Frrrrrrrrrank/CAN_Debugger/CAN_Debugger.kicad/CAN_Debugger.kicad_pcb

## KiCad design CAN_Debugger.kicad/CAN_Debugger.kicad_pcb (2023-10-15)

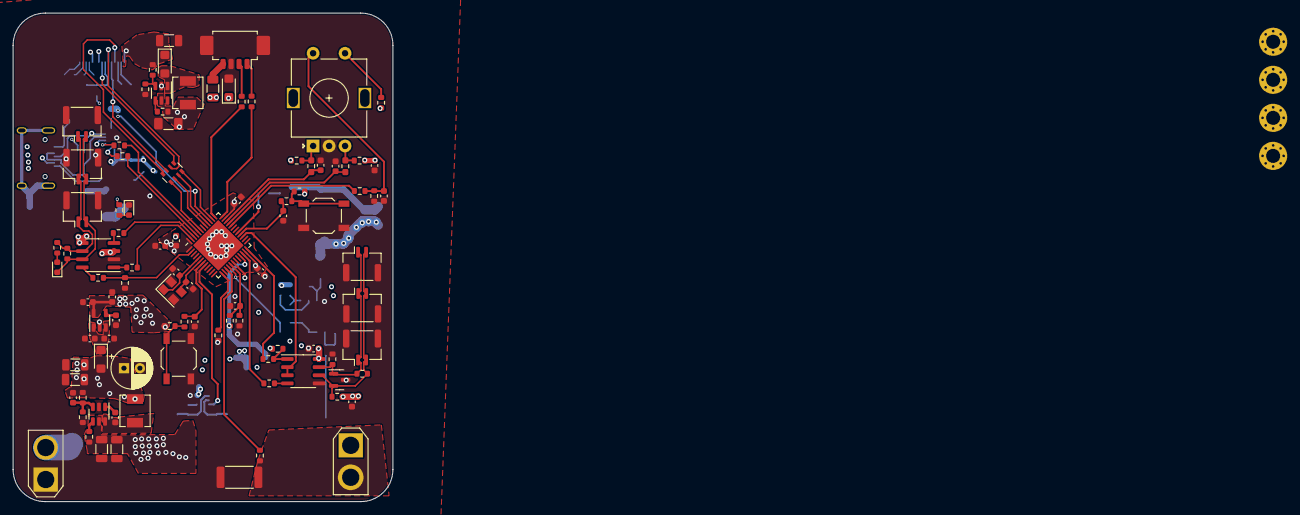
[picture p1: board CAN_Debugger.kicad_pcb from above]

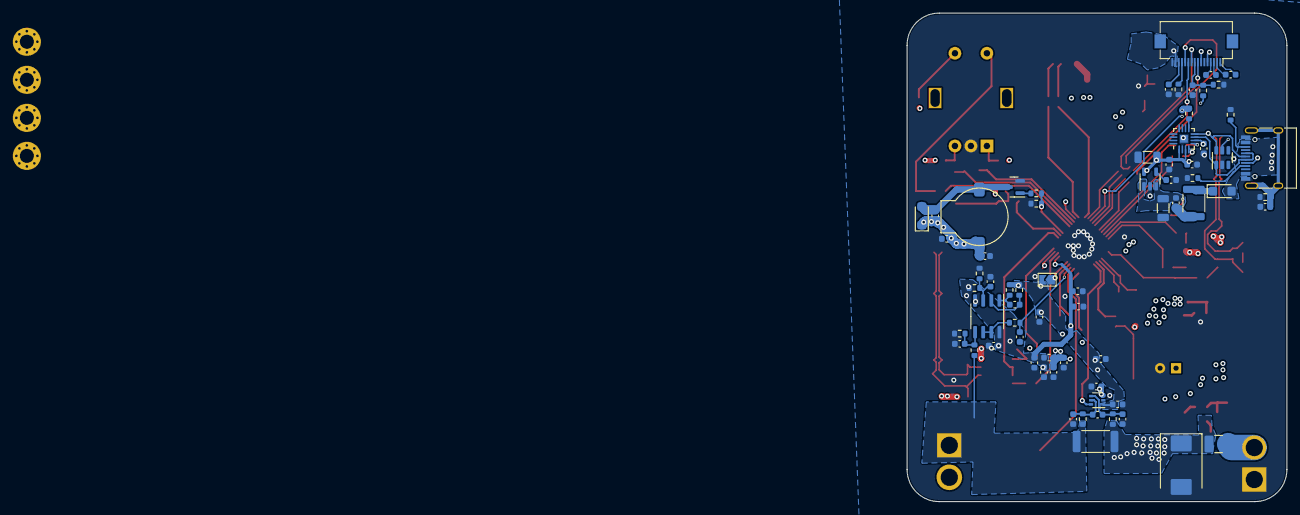
[picture p2: board CAN_Debugger.kicad_pcb from below]

Board: 4 copper layers, 59.4 x 76.4 mm, 169 parts (68 on the bottom side), 102 nets.

Parts:
BZ1: Buzzer; MLT-9032
C1, C2, C6, C7, C37, C45: 10uF; C_1206_3216Metric
C3: 47uF; CP_Radial_D6.3mm_P2.50mm
C4, C9, C12, C25, C26, C27, C28, C30, C31, C33, C34, C35, C38, C39, C40, C41, C42, C46, C49, C50, C57, C58, C59, C70, C76, C88, C104, C105: 100n; C_0603_1608Metric
C5, C8, C14, C23: 20p; C_0603_1608Metric
C10, C13, C22, C24, C29, C80: 10u; C_0603_1608Metric
C11: 10n; C_0603_1608Metric
C15, C16: 1uf; C_0603_1608Metric
C17: 2.2uf; C_0603_1608Metric
C20, C21, C36: 100nF; C_0603_1608Metric
C32, C47, C52, C53, C54: C; C_0603_1608Metric
C43, C44: 10nF; C_0603_1608Metric
C48: 22u; C_1206_3216Metric
C51: 22u; C_1206_3216Metric_Pad1.33x1.80mm_HandSolder
D1: SMCJ28A; D_SMC
D3, D5, D6, D10: D_Schottky; D_SMF
D4, D9: LED; LED_0603_1608Metric
D7: SMF3.3A; D_SMF
D8: SM712; SOT-23
F1: Fuse; Fuse_1210_3225Metric_Pad1.42x2.65mm_HandSolder
F2: Polyfuse; Fuse_1206_3216Metric
F4: Fuse; Fuse_1812_4532Metric
FB1: 120R@100MHz; L_0603_1608Metric
H1, H2, H3, H4: MountingHole_Pad; MountingHole_2.2mm_M2_Pad_Via
J1: Conn_01x02; AMASS_XT30U-M_1x02_P5.0mm_Vertical
J2: Conn_01x04_MountingPin; Molex_PicoBlade_53261-0471_1x04-1MP_P1.25mm_Horizontal
J3: Conn_01x02; AMASS_XT30U-F_1x02_P5.0mm_Vertical
J4: Conn_01x16_Socket; Hirose_FH12-16S-0.5SH_1x16-1MP_P0.50mm_Horizontal
J5: USB_C_Receptacle_USB2.0; USB_C_Receptacle_HRO_TYPE-C-31-M-12
J6: RS-485; JST_GH_BM02B-GHS-TBT_1x02-1MP_P1.25mm_Vertical
J7, J8, J9: CAN; JST_GH_BM02B-GHS-TBT_1x02-1MP_P1.25mm_Vertical
J15, J16: RS-485; JST_GH_SM02B-GHS-TB_1x02-1MP_P1.25mm_Horizontal
JP1: SolderJumper_2_Open; SolderJumper-2_P1.3mm_Open_TrianglePad1.0x1.5mm
L1: L; L_Sunlord_MWSA0402S
L2: 4.7u; L_Sunlord_MWSA0402S
L3: L_Ferrite; L_0603_1608Metric
Q1: AO3400A; SOT-23
R1, R3, R10, R19, R23, R28, R38, R39, R40, R42, R50: 10k; R_0603_1608Metric
R2: 53.6k; R_0603_1608Metric
R4, R44: R; R_2512_6332Metric
R5: 330R; R_0603_1608Metric
R6, R31: 10k; R_0603_1608Metric_Pad0.98x0.95mm_HandSolder
R7, R8, R11, R20, R63: 33r; R_0603_1608Metric
R9, R12, R13, R57: 120r; R_0603_1608Metric
R14, R15, R45, R51: R; R_0603_1608Metric
R16, R17, R21: 100k 25ppm; R_0603_1608Metric
R18, R22, R27: 330; R_0603_1608Metric
R24, R62: 1k; R_0603_1608Metric
R25: 10k 25ppm; R_0603_1608Metric
R29: 120R; R_0603_1608Metric
R30, R36: 10K; R_0603_1608Metric
R32, R33: 33R; R_0603_1608Metric
R34, R35: 5.1k; R_0603_1608Metric
R37: 1M; R_0603_1608Metric
R41, R48, R52: 100k; R_0603_1608Metric
R53, R56, R58: 4.7k; R_0603_1608Metric
R54, R55: 100; R_0603_1608Metric
R59, R60: 100r 25ppm; R_0603_1608Metric
R61: 19k; R_0603_1608Metric
RN1: R_Pack04; R_Array_Convex_4x0603
SW1, SW3: SW_Push; SW_SPST_TL3342
SW4: RotaryEncoder_Switch; RotaryEncoder_Alps_EC11E-Switch_Vertical_H20mm
U1: SN75176AD; SOIC-8_3.9x4.9mm_P1.27mm
U2: RY8411; SOT-23-6
U3, U10: RS3236; SOT-23-5
U5: SIT1042T/3; SOIC-8_3.9x4.9mm_P1.27mm
U6: IP4220CZ6; SOT-23-6
U7: INA186; SOT-363_SC-70-6
U8: STM32G431CBUx; QFN-48-1EP_7x7mm_P0.5mm_EP5.6x5.6mm
U9: CH343P; TQFN-16-1EP_3x3mm_P0.5mm_EP1.23x1.23mm
U13: MT3608; SOT-23-6
U14: GS8332-SR; SOIC-8_3.9x4.9mm_P1.27mm
Y1: 25MHz; Crystal_SMD_3225-4Pin_3.2x2.5mm

Connections:
24v_motor: J3.1, R4.2, R21.2, R60.1
+3.3V: C12.1, C13.1, C25.1, C26.1, C27.1, C28.1, C32.1, C41.1, C42.1, C52.1, D7.1 (A1), F2.1, J4.7, L3.1, R19.1, R23.1, R38.1, R39.2, R40.1, R53.1, U3.5 (OUT), U5.5 (VIO), U7.3 (V+), U8.1 (VBAT), U8.23 (VDD), U8.35 (VDD), U8.48 (VDD)
+3.3VA: C29.1, C30.1, C53.1, C54.1, C70.1, L3.2, R16.2, R48.1, U8.21 (VDDA), U14.8 (VDD)
+3.3V_USBTTL: C20.1, C21.1, C36.1, C45.1, U9.1 (VIO), U9.3 (VDD5), U9.6 (V3), U10.5 (OUT)
+5V: BZ1.2 (+), C1.1, C2.1, C3.1, C5.1, C22.2, C23.2, C24.2, C49.1, C50.1, C51.1, D3.2 (A), D5.1 (K), J4.5, L1.2, L2.1, R2.1, R50.1, R58.2, U1.8 (VCC), U5.3 (VCC), U13.5 (IN)
+24V: C6.1, C7.1, D1.1 (K), F1.1, R1.1, R4.1, R59.1, U2.5 (IN)
/1.65Vref: C40.1, C76.1, C80.1, JP1.2 (B), R20.1, R24.1, U7.1 (REF)
/VBUS_CONNECTOR: D6.2 (A), J5.A4 (VBUS), J5.A9 (VBUS), J5.B4 (VBUS), J5.B9 (VBUS)
A+: D8.2 (A2), J6.2, J15.2, J16.2, R57.2, R58.1, U1.6 (A)
A_I: U7.6, U8.8 (PA0)
B-: D8.1 (A1), J6.1, J15.1, J16.1, R56.2, R57.1, U1.7 (B)
BUZZER: R10.2, R11.1, U8.29 (PC6)
C1N: C16.2, J4.4
C1P: C16.1, J4.3
C2N: C15.2, J4.2
C2P: C15.1, J4.1
CANH: D9.1 (K), J7.2, J8.2, J9.2, R9.2, U5.7 (CANH)
CANL: J7.1, J8.1, J9.1, R9.1, R15.1, U5.6 (CANL)
CAN_RX: R8.1, U8.46 (PB8)
CAN_STB: R29.1, R30.1, U8.2 (PC13)
CAN_TX: R7.1, U8.47 (PB9)
CS: J4.8, RN1.5 (R4.2)
D/C: J4.10, RN1.6 (R3.2)
Encoder_button: R42.1, U8.32 (PA10)
GND: C1.2, C2.2, C3.2, C6.2, C7.2, C8.2, C9.2, C10.2, C11.2, C12.2, C13.2, C14.2, C17.2, C20.2, C21.2, C22.1, C24.1, C25.2, C26.2, C27.2, C28.2, C29.2, C30.2, C31.1, C32.2, C33.1, C35.1, C36.2, C37.2, C38.1, C39.2, C40.2, C41.2, C42.2, C43.1, C44.2, C45.2, C46.2, C47.2, C48.2, C49.2, C50.2, C51.2, C52.2, C53.2, C54.2, C57.2, C59.2, C70.2, C76.2, C80.2, C88.1, C104.1, C105.2, D1.2 (A), D4.1 (K), D7.2 (A2), D8.3 (common), J1.1, J2.3, J2.MP (MountPin), J4.16, J5.A1 (GND), J5.A12 (GND), J5.B1 (GND), J5.B12 (GND), J6.MP (MountPin), J7.MP (MountPin), J8.MP (MountPin), J9.MP (MountPin), J15.MP (MountPin), J16.MP (MountPin), Q1.2 (S), R3.2, R10.1, R14.2, R17.1, R25.1, R28.2, R30.2, R34.1, R35.1, R37.1, R41.2, R44.1, R51.2, R52.2, R56.1, R62.2, SW1.2, SW3.2, SW4.C, U1.5 (GND), U2.2 (GND), U3.2 (GND), U5.2 (GND), U6.2 (VN), U7.2 (GND), U8.49 (VSS), U9.2 (GND), U9.17 (GND), U10.2 (GND), U13.2 (GND), U14.4 (VSS), Y1.2, Y1.4
IREF: J4.13, R14.1
NRST: C31.2, R18.2, U8.7 (PG10)
unnamed: BZ1.1 (-), C23.1, D5.2 (A), Q1.3 (D)
unnamed: C46.1, R41.1, R42.2, SW4.S2
unnamed: C57.1, R16.1, R17.2, U14.3 (+)
unnamed: C58.2, R24.2, U14.2 (-)
unnamed: C59.1, R21.1, R25.2, U14.5 (+)
unnamed: C9.1, C10.1, D3.1 (K), U3.1 (IN), U3.3 (EN)
unnamed: D4.2 (A), R36.2
unnamed: D6.1 (K), F4.2
unnamed: D9.2 (A), R15.2
unnamed: D10.2 (A), L2.2, U13.1 (SW)
unnamed: F4.1, FB1.2
unnamed: F1.2, J1.2
unnamed: J2.1, R13.2
unnamed: J2.2, R12.2
unnamed: F2.2, J2.4
unnamed: J5.A5 (CC1), R34.2
unnamed: J5.B5 (CC2), R35.2
unnamed: C43.2, J5.S1 (SHIELD), R37.2
unnamed: Q1.1 (G), R11.2
unnamed: R18.1, R19.2, SW1.1
unnamed: R22.1, R23.2, SW3.1
unnamed: R31.2, R38.2, SW4.B
unnamed: R6.2, R39.1, SW4.A
unnamed: R40.2, SW4.S1
unnamed: R54.1, U1.4 (D)
unnamed: R53.2, R55.2, U1.1 (R)
unnamed: C4.1, U2.1 (BS)
unnamed: R1.2, U2.4 (EN)
unnamed: C5.2, R2.2, R3.1, U2.3 (FB)
unnamed: C4.2, L1.1, U2.6 (LX)
unnamed: C11.1, U3.4 (BP/FB)
unnamed: R8.2, U5.4 (RXD)
unnamed: R29.2, U5.8 (STB)
unnamed: R7.2, U5.1 (TXD)
unnamed: C34.1, C104.2, R59.2, U7.4 (+)
unnamed: C34.2, C105.1, R60.2, U7.5 (-)
unnamed: R32.2, U9.5 (RXD)
unnamed: R33.1, U9.4 (TXD)
unnamed: R5.1, U9.9 (VBUS)
unnamed: C44.1, U10.4 (BP)
unnamed: R50.2, U13.4 (EN)
unnamed: R61.2, R62.1, U13.3 (FB)
unnamed: C58.1, R20.2, U14.1 (OUTA)
unnamed: R63.1, U14.6 (-), U14.7 (OUTB)
PA5: R51.1, U8.13 (PA5)
PA7: R45.1, U8.15 (PA7)
PA11: C39.1, R31.1, U8.33 (PA11)
PA12: C38.2, R6.1, U8.34 (PA12)
PA15: RN1.4 (R4.1), U8.38 (PA15)
PB0: C47.1, R48.2, R52.1, U8.17 (PB0)
PB1: JP1.1 (A), U8.18 (PB1)
PB6: R32.1, U8.44 (PB6)
PB7: R33.2, U8.45 (PB7)
PB10: R54.2, U8.22 (PB10)
PB11: R55.1, U8.24 (PB11)
PB14: U1.2 (~RE), U1.3 (DE), U8.27 (PB14)
PB15: C33.2, R22.2, U8.28 (PB15)
PC4: C88.2, R63.2, U8.16 (PC4)
PC10: R27.1, U8.39 (PC10)
PC11: RN1.3 (R3.1), U8.40 (PC11)
RCC_OSC_IN: C14.1, U8.5 (PF0), Y1.1
RCC_OSC_OUT: C8.1, U8.6 (PF1), Y1.3
RES: C35.2, J4.9, R27.2, R28.1
SCLK: J4.11, RN1.7 (R2.2)
SDIN: J4.12, RN1.8 (R1.2)
SPI1_MOSI: RN1.1 (R1.1), U8.43 (PB5)
SPI1_SCK: RN1.2 (R2.1), U8.41 (PB3)
SYS_JTCK-SWDCLK: R12.1, U8.37 (PA14)
SYS_JTMS-SWDIO: R13.1, U8.36 (PA13)
USB_UART_DM: J5.A7 (D-), J5.B7 (D-), U6.6 (IO4), U9.8 (VD-)
USB_UART_DP: J5.A6 (D+), J5.B6 (D+), U6.1 (IO1), U9.7 (VD+)
VBUS_USBTTL: C37.1, FB1.1, R5.2, R36.1, U6.5 (VP), U10.1 (IN), U10.3 (EN)
VCC: C48.1, D10.1 (K), J4.15, R61.1
VCOMH: C17.1, J4.14
iA+: J3.2, R44.2, R45.2
