Frrrrrrrrrank/CAN_Debugger/Software/Software.ioc

Mcu.UserName=STM32G431CBUx
PA0.GPIO_Label=I_AMPLIFIED_SENSE
PA0.Signal=ADC2_IN1
PA10.Signal=GPIO_Input
PA11.Signal=S_TIM4_CH1
PA12.Signal=S_TIM4_CH2
PA13.Signal=SYS_JTMS-SWDIO
PA14.Signal=SYS_JTCK-SWCLK
PA15.Signal=SPI1_NSS
PA5.Signal=OPAMP2_VINM0
PA7.Signal=OPAMP2_VINP
PB10.Signal=USART3_TX
PB11.Signal=USART3_RX
PB14.Signal=USART3_DE
PB15.GPIO_Label=BTN1
PB15.Signal=GPIO_Input
PB3.Signal=SPI1_SCK
PB5.Signal=SPI1_MOSI
PB6.Signal=USART1_TX
PB7.Signal=USART1_RX
PB8-BOOT0.Signal=FDCAN1_RX
PB9.Signal=FDCAN1_TX
PC10.GPIO_Label=OLED_RST
PC10.Signal=GPIO_Output
PC11.GPIO_Label=OLED_DC
PC11.Signal=GPIO_Output
PC13.GPIO_Label=CAN_STB
PC13.Signal=GPIO_Output
PC4.GPIO_Label=V_BUFFERED_SENSE
PC4.Signal=ADC2_IN5
PC6.Signal=S_TIM8_CH1
PF0-OSC_IN.Signal=RCC_OSC_IN
PF1-OSC_OUT.Signal=RCC_OSC_OUT
