Frrrrrrrrrank/CAN_Debugger/Software/Core/Inc/main.h

#define CAN_STB_Pin GPIO_PIN_13
#define CAN_STB_GPIO_Port GPIOC
#define I_AMPLIFIED_SENSE_Pin GPIO_PIN_0
#define I_AMPLIFIED_SENSE_GPIO_Port GPIOA
#define V_BUFFERED_SENSE_Pin GPIO_PIN_4
#define V_BUFFERED_SENSE_GPIO_Port GPIOC
#define BTN1_Pin GPIO_PIN_15
#define BTN1_GPIO_Port GPIOB
#define OLED_RST_Pin GPIO_PIN_10
#define OLED_RST_GPIO_Port GPIOC
#define OLED_DC_Pin GPIO_PIN_11
#define OLED_DC_GPIO_Port GPIOC
