Frrrrrrrrrank/CAN_Debugger/(commit log)

2023-09-02 Add files via upload
    update sch
    [CAN_Debugger.kicad_pcb, CAN_Debugger.kicad_sch]
2023-09-04 Kicad Schematic done
    [CAN_Debugger.kicad_sch]
2023-09-06 Changing schematic; Change cubemx ioc to G431
    [CAN_Debugger.kicad_sch]
2023-09-21 update sche
    [CAN_Debugger.kicad_pcb, CAN_Debugger.kicad_sch]
2023-10-03 update schematic
    [CAN_Debugger.kicad_pcb, CAN_Debugger.kicad_sch]
2023-10-07 Add Hardware Core; Add Handsolder QFN48 Footprint; Changes in schematic texts
    [CAN_Debugger.kicad_sch]
2023-10-15 Update PCB layout
    [CAN_Debugger.kicad_pcb, CAN_Debugger.kicad_sch]
2023-10-26 Generated Code from CubeMX and CLion
    [CAN_Debugger.kicad_sch]
2023-11-02 Add C++ Tasks.cpp; Still some bugs, cannot compile cpp
    [Buzzer.hpp, Software.ioc, Tasks.cpp, main.h]
2023-11-04 1. Able to compile by cmake; Makefile still cannot. 2. Able to beep 3. Able to read ADC of input voltage (But with big noise) -- Need VREF changes 4. Needs Boot0 changes
    [Buzzer.hpp, Software.ioc, Tasks.cpp]
2023-11-05 1. Use External VRef: shorted VREF and VDDA 2. Read Amplified Current Value
    [Software.ioc, Tasks.cpp]
2023-11-08 1. Update Makefile 2. Able to read current and voltage 3. Internal Opamp for current sense
